AdlerFarHorizons/TwoWayComm/README.md

TwoWayComm
==========

Two-way wireless communication for telemetry and control.
