AdlerFarHorizons/TwoWayComm/software/archive/2waycommJuly30workingCode/readme.txt.odt

This version of the 2 way comm system transmits 3 bytes data every 10 seconds from the balloon to the ground hub and the ground can send commands to the balloon to get some data on demand.

How to transmit

Step 1: use first and second byte of the allocated transmission buffer TXS as Headers

TXS[tsp][0]=1;//on the other side the source will be 1

TXS[tsp][1]=10;//futher identification

Step 2: set the third byte of the TXS and on to be data that is being transmitted

TXS[tsp][2]=collect2(5,1);//collecting from a peripheral using I2C

Step 3: place the message on the transmission buffer

if(!fulT)//checking if the buffer

{

TX_Buffer[tsi].content=TXS[tsp];//pushing the packet onto the buffer

TX_Buffer[tsi].size=3;(make sure to set the correct size which in this case is 3 bytes)

//Serial.println("pushed1");

}

tsp=inc(tsp);//updating the allocated TX space index

fulT=enqueueT(); //

Note: when transmitting data the transmission must be contained within an if statement so that it only happens when needed , like an it is also recommended that all transmission setups statements should be placed inside the ISR unless the data is collected with the collect2() function then it will be placed in the main loop of the program

How to see received data

when a new message is received it is placed on a buffer to check for a specific message write an if statement checking a variable called source to see if its the expected message or and then look into the variable called current which will be an array of bytes for the rest of the message

example: if(source==2){

dosomethng();

source=0;}

How to set periodic tranmissions
