AdlerFarHorizons/TwoWayComm/scratchpad/flowchart.png

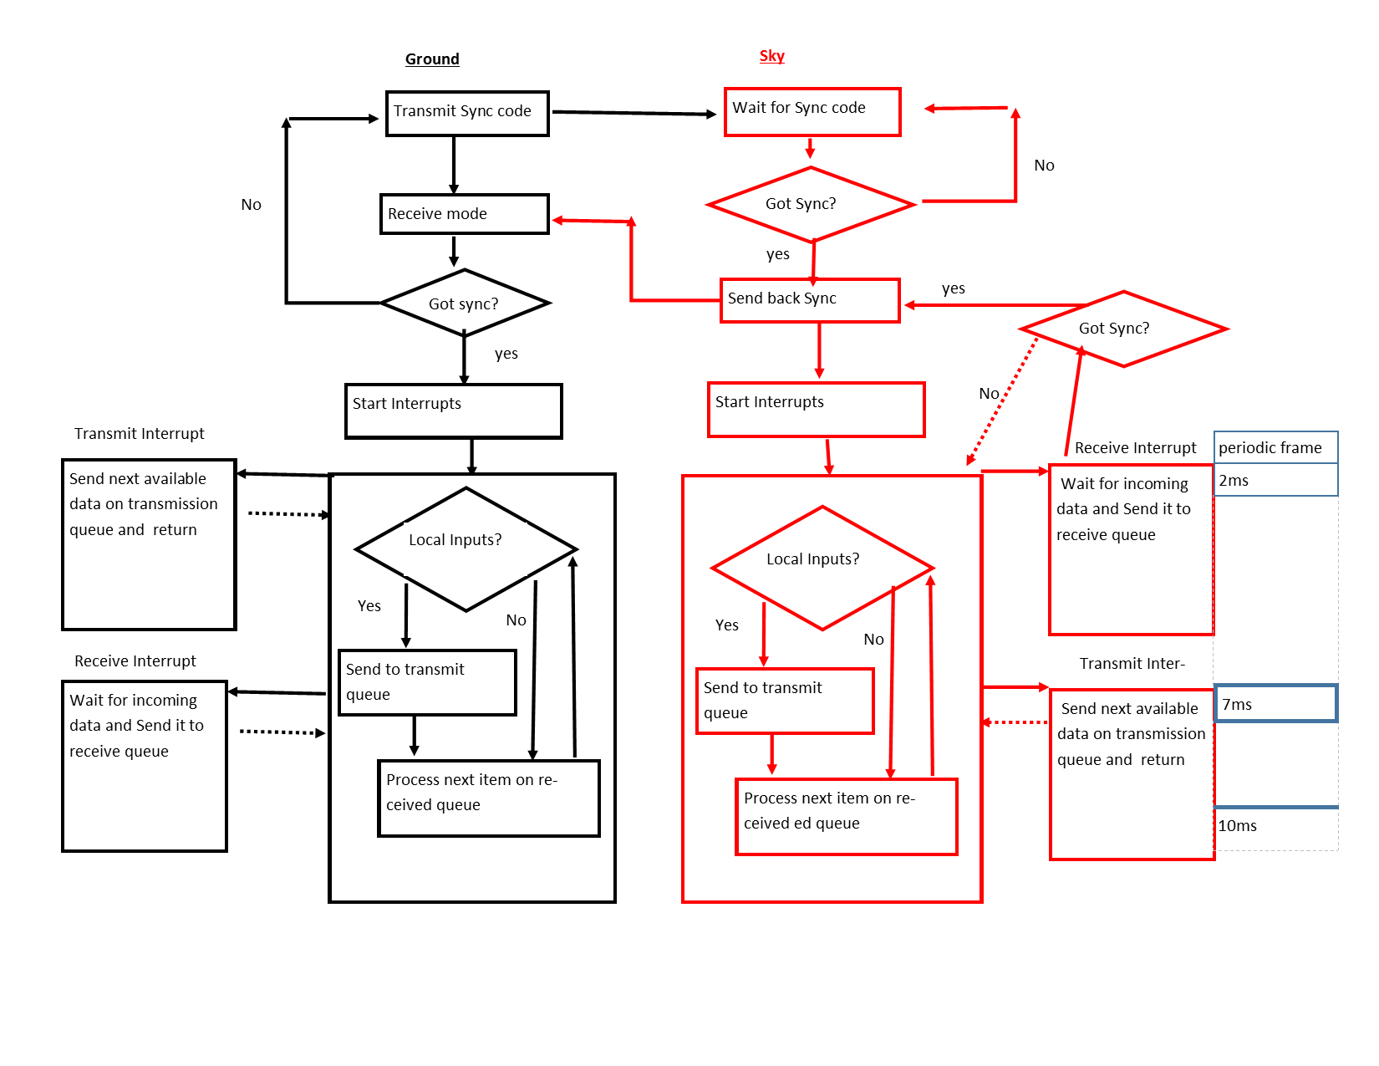
scratchpad/flowchart.png
