AdlerFarHorizons/TwoWayComm/scratchpad/IO.png

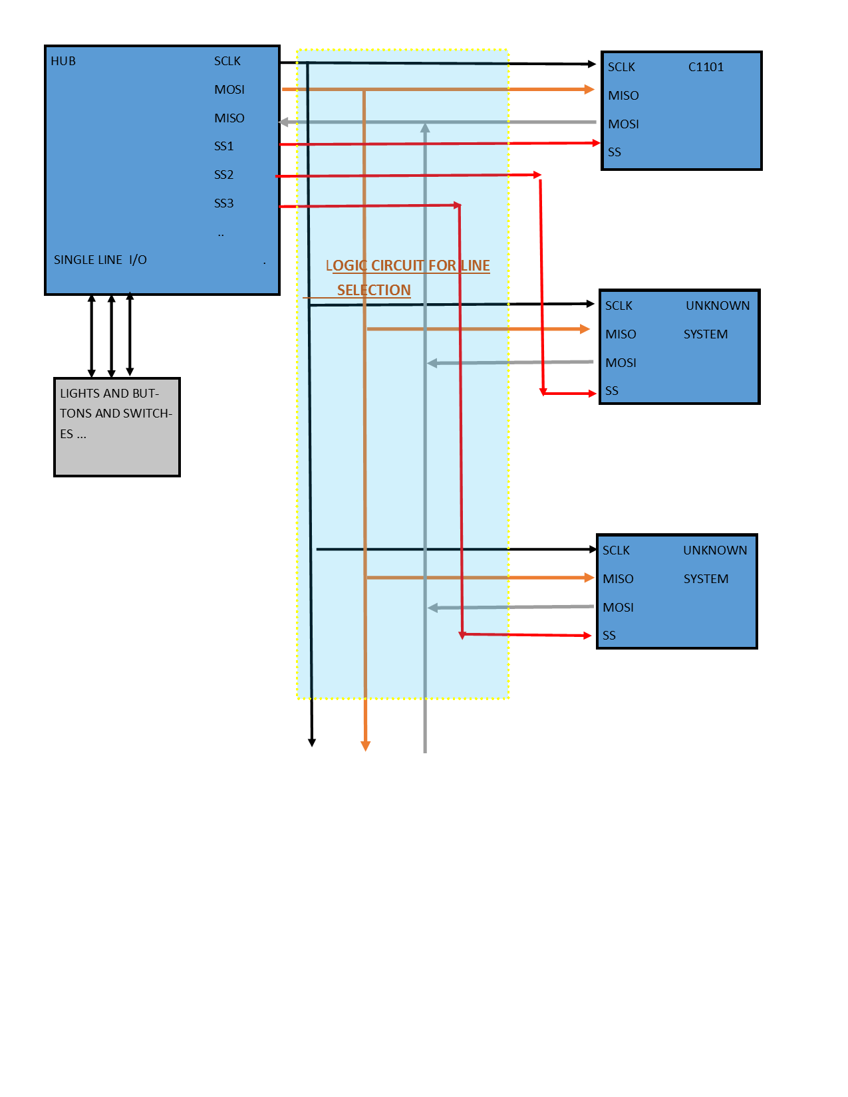
scratchpad/IO.png
