AdlerFarHorizons/TwoWayComm/(commit log)

2013-08-22 New stuff
    [DefaultConfigValues_RADIO_library.txt]
2014-01-31 General update
    [CC1101-1190EM_Adapter_V1_00.brd, CC1101-1190EM_Adapter_V1_00.sch, CC1101-1190EM_Adapter_V1_01.brd, CC1101-1190EM_Adapter_V1_01.sch, CC1101-1190EM_Adapter_V2.00.brd, CC1101-1190EM_Adapter_V2.00.sch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]
